mowesta/weatherstation/README.md

# weatherstation
Source code and schematics for an Arduino-based weather station.
