mowesta/weatherstation/CAD Files/Print ready/FixPanelhalter.stl

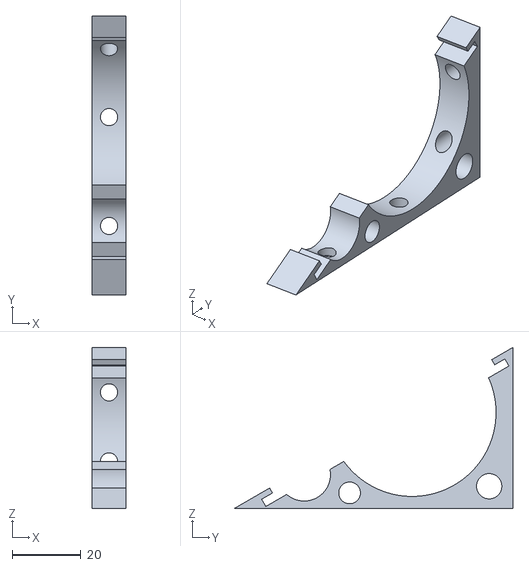
[picture p1: CAD file, 2020-05-13]
CAD Files/Print ready/FixPanelhalter.stl
10.0 x 81.3 x 47.0
