mowesta/weatherstation/CAD Files/Print ready/deckel.stl

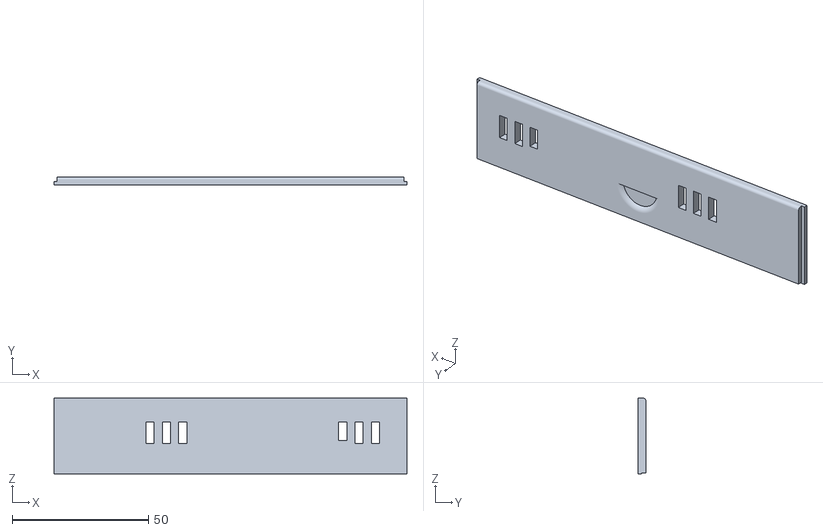
[picture p2: CAD file, 2020-05-04]
CAD Files/Print ready/deckel.stl
129.4 x 2.80 x 27.9
