mowesta/weatherstation/CAD Files/Print ready/VariPanelhalter.stl

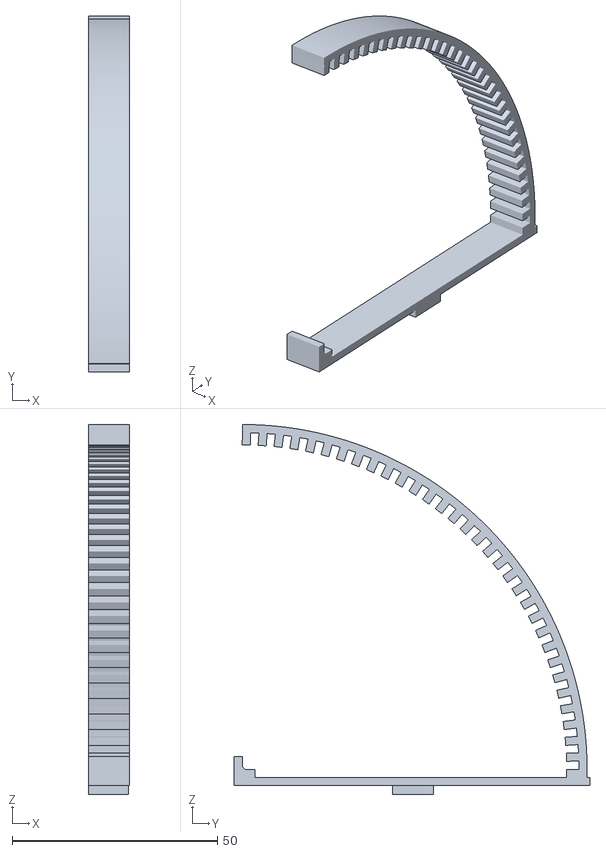
[picture p3: CAD file, 2020-05-04]
CAD Files/Print ready/VariPanelhalter.stl
10.0 x 86.7 x 90.2
