mowesta/weatherstation/CAD Files/Print ready/gehaeuse.stl

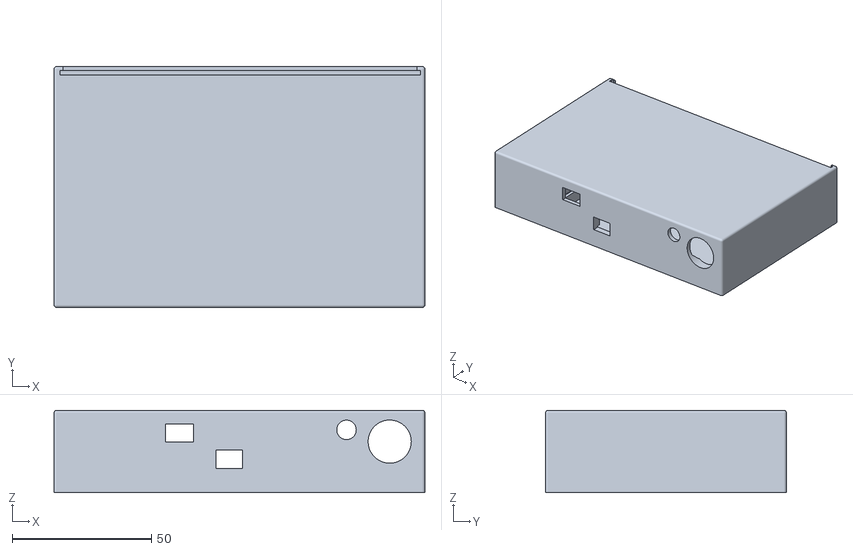
[picture p4: CAD file, 2020-05-04]
CAD Files/Print ready/gehaeuse.stl
133.4 x 86.7 x 29.7
