mowesta/weatherstation/CAD Files/Print ready/VariPanelhalterFuss.stl

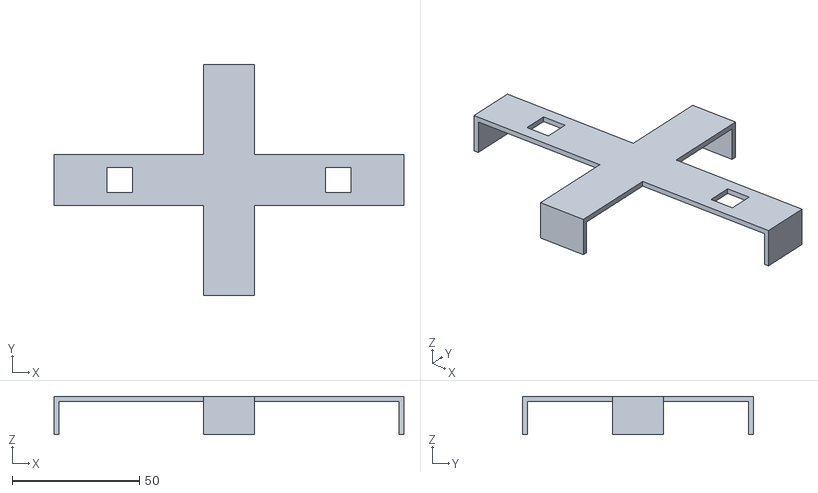
[picture p5: CAD file, 2020-05-04]
CAD Files/Print ready/VariPanelhalterFuss.stl
137.6 x 91.0 x 15.0
