mowesta/weatherstation/Eagle PCB Files/MoWeSta-Minimalist.brd

## EAGLE design Eagle PCB Files/MoWeSta-Minimalist.brd (2022-11-13)

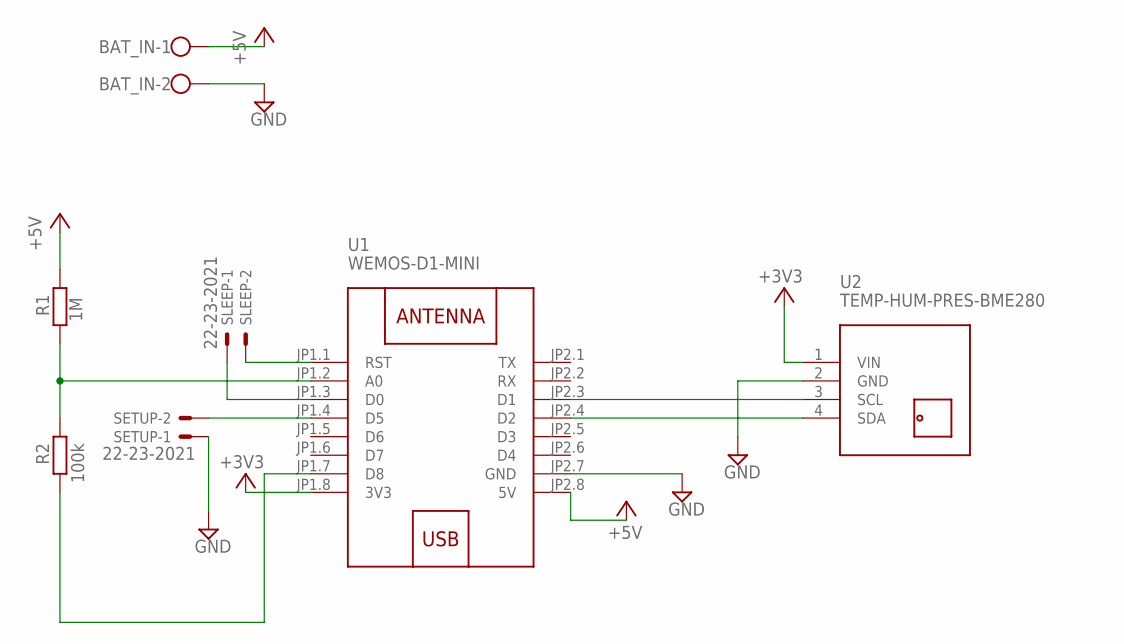
[picture p6: schematic MoWeSta-Minimalist.sch]

Parts:
BAT_IN: W237-102
R1: 1M; 0204/7
R2: 100k; 0204/7
SETUP: 22-23-2021
SLEEP: 22-23-2021
U1: WEMOS-D1-MINI
U2: TEMP-HUM-PRES-BME280

Connections:
+3V3: U1.JP1.8 (3V3), U2.1 (VIN)
+5V: BAT_IN.1, R1.2, U1.JP2.8 (5V)
GND: BAT_IN.2, SETUP.1, U1.JP2.7 (GND), U2.2 (GND)
unnamed: R1.1, R2.2, U1.JP1.2 (A0)
unnamed: SLEEP.2, U1.JP1.1 (RST)
unnamed: SLEEP.1, U1.JP1.3 (D0)
unnamed: SETUP.2, U1.JP1.4 (D5)
unnamed: U1.JP2.3 (D1), U2.3 (SCL)
unnamed: U1.JP2.4 (D2), U2.4 (SDA)
unnamed: R2.1, U1.JP1.7 (D8)

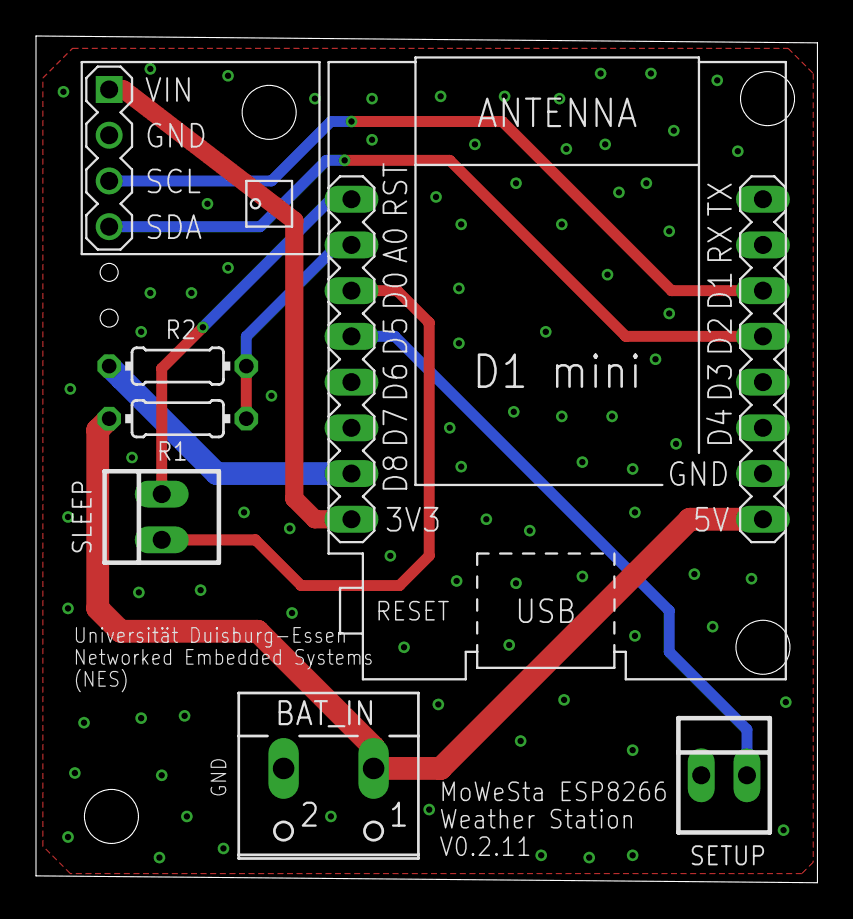
[picture p7: board MoWeSta-Minimalist.brd from above]

Board: 2 copper layers, 43.4 x 47.0 mm, 7 parts (0 on the bottom side), 10 nets.
