mowesta/weatherstation/Eagle PCB Files/MoWeSta-Weatherstation.brd

## EAGLE design Eagle PCB Files/MoWeSta-Weatherstation.brd (2020-05-04)

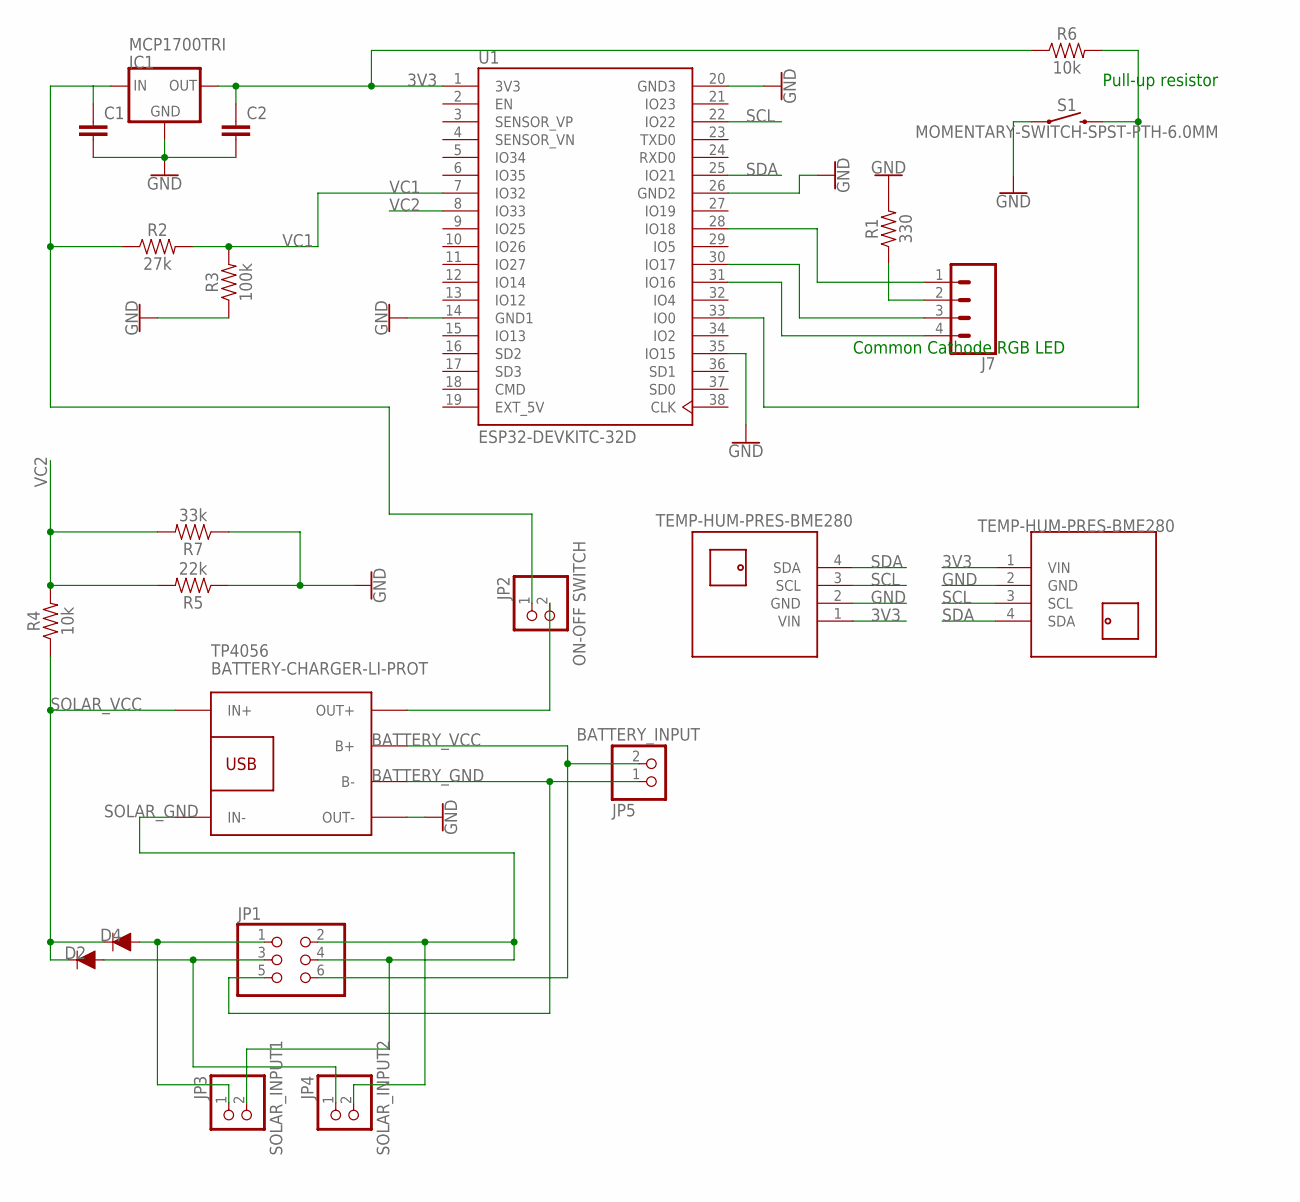
[picture p8: schematic MoWeSta-Weatherstation.sch]

Parts:
C1: 10nF; C050-025X075
C2: C-EU050-025X075; C050-025X075
D2, D4: 1A/50V/1.1V; DIODE-1N4001
IC1: MCP1700TRI; TO92-INLINE
J7: CONN_04; 1X04
JP1: PINHD-2X3/90; 2X03/90
JP2: ON-OFF SWITCH; 1X02
JP3: SOLAR_INPUT1; 1X02
JP4: SOLAR_INPUT2; 1X02
JP5: BATTERY_INPUT; 1X02
R1: 330; AXIAL-0.3
R2: 27k; AXIAL-0.3
R3: 100k; AXIAL-0.3
R4, R6: 10k; AXIAL-0.3
R5: 22k; AXIAL-0.3
R7: 33k; AXIAL-0.3
S1: MOMENTARY-SWITCH-SPST-PTH-6.0MM; TACTILE_SWITCH_PTH_6.0MM
TP4056: BATTERY-CHARGER-LI-PROT
U1: ESP32-DEVKITC-32D; MODULE_ESP32-DEVKITC-32D
U$3, U$4: TEMP-HUM-PRES-BME280

Connections:
3V3: C2.1, IC1.3 (OUT), R6.P$1 (1), U1.1 (3V3), U$3.1 (VIN), U$4.1 (VIN)
BATTERY_GND: JP1.5, JP5.1, TP4056.B-
BATTERY_VCC: JP1.6, JP5.2, TP4056.B+
EXT_5V: U1.19 (EXT_5V)
GND: C1.2, C2.2, IC1.1 (GND), R1.P$2 (2), R3.P$1 (1), R5.P$1 (1), R7.P$1 (1), S1.1, TP4056.OUT-, U1.14 (GND1), U1.20 (GND3), U1.26 (GND2), U1.35 (IO15), U$3.2 (GND), U$4.2 (GND)
unnamed: D2.A, JP1.3, JP4.1
unnamed: D4.A, JP1.1, JP3.1
unnamed: J7.2, R1.P$1 (1)
unnamed: C1.1, IC1.2 (IN), JP2.1, R2.P$1 (1)
unnamed: J7.1, U1.28 (IO18)
unnamed: JP2.2, TP4056.OUT+
unnamed: J7.4, U1.31 (IO16)
unnamed: R6.P$2 (2), S1.3 (2), U1.33 (IO0)
unnamed: J7.3, U1.30 (IO17)
SCL: U1.22 (IO22), U$3.3 (SCL), U$4.3 (SCL)
SDA: U1.25 (IO21), U$3.4 (SDA), U$4.4 (SDA)
SOLAR_GND: JP1.2, JP1.4, JP3.2, JP4.2, TP4056.IN-
SOLAR_VCC: D2.C, D4.C, R4.P$1 (1), TP4056.IN+
VC1: R2.P$2 (2), R3.P$2 (2), U1.7 (IO32)
VC2: R4.P$2 (2), R5.P$2 (2), R7.P$2 (2), U1.8 (IO33)

Notes on the sheet:
Pull-up resistor
Common Cathode RGB LED

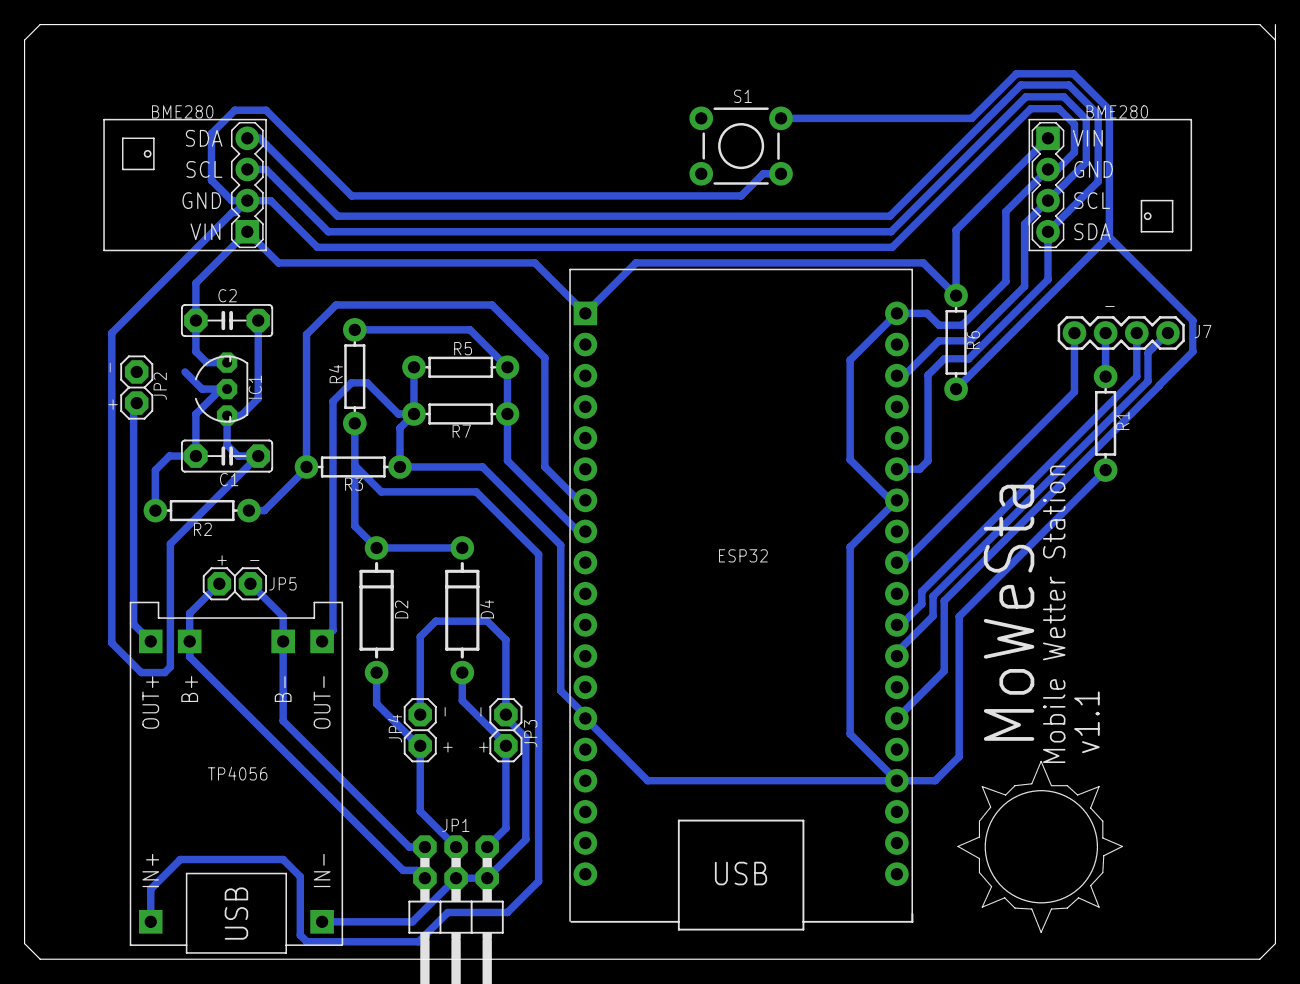
[picture p9: board MoWeSta-Weatherstation.brd from above]

Board: 2 copper layers, 102.0 x 76.2 mm, 23 parts (0 on the bottom side), 19 nets.
