mowesta/weatherstation/(commit log)

2020-05-04 PCB Files
    [MoWeSta-Weatherstation.brd, MoWeSta-Weatherstation.sch]
2020-05-04 3D-Print ready
    [Panelhalter.stl, deckel.stl, gehäuse.stl, gehäuseaufsatz.stl]
2020-05-13 Panelhalter Fuß
    [VariPanelhalterFuss.stl]
2020-06-26 Fix sensor code, change protocol and fix synchronization.
    Multiply humidity value by 100 before sending it to the backend.
    Flatten json structure for receiving configuration information.
    Modify configuration protocol to avoid races in Android app.
    [h_RECEIVE_CLIENT_DATA.ino, i_READ_SENSOR_DATA.ino]
2022-11-13 Added code and pcb for minimalistic station with ESP8266.
    [MoWeSta-Minimalist.brd, MoWeSta-Minimalist.sch]
